8423/cryocooler-board/V4_BOM.csv

Id | Designator | Footprint | Quantity | Designation | Supplier and ref
1 | C11,CIN3 | EEH-ZA1V680XP | 2 | 68uF
2 | C10 | GCM21BR72A104KA37L | 1 | .1uF
3 | J1,J3,J2 | MOLEX_4_pin | 3 | MOL Pico 4
4 | R2,R1 | CRCW12062K20JNEA | 2 | 2.20k
5 | C1,C2,C9 | GCM21BR72A104KA37L | 3 | 0.1uF
6 | C8,C7,CIN4 | CGA3E3X5R1H105M080AB | 3 | 1uF
7 | R5 | CRCW08052K00FKEA | 1 | 5k
8 | U3 | 0685T4000-01 | 1 | C1T 4
9 | Cdith1 | CGA3E2X7R1H473K080AD | 1 | 0.047uF
10 | C3,CIN2,C4,C5,CIN1,C6 | CGA5L1X7R1H106K160AC | 6 | 10uF
11 | TP_VIN1,TP_SCL1,TP_SDA1,TP_VOUT1,TP_AGND1,TP_PGND1 | TestPoint_THTPad_D1.5mm_Drill0.7mm | 6 | TestPoint
12 | U2 | AD5258BRMZ1_IC | 1 | AD5258BRMZ1
13 | R3 | CRF1206-FZ-R010ELF | 1 | 10mili Ohms
14 | R4 | CRCW080530K9FKEA | 1 | 30k
15 | Cp1 | CGA3E2NP01H220J080AA | 1 | 22pF
16 | R8,R7 | CRCW08051R00JNEAHP | 2 | 1 ohm
17 | Rfsw1 | CRCW060310K0FKEA | 1 | 32.4K
18 | Rc1 | CRCW060326K1FKEA | 1 | 26.1k
19 | J4 | MOLEX_2_pin | 1 | MOL Pico 2
20 | R6 | CRCW120620K0FKEAC | 1 | 20k
21 | CVCC1 | GRT188R61C475KE13D | 1 | 4.7uF
22 | Q1,Q2 | IPZ40N04S5L4R8ATMA1 | 2 | IPZ40N04S5-3R1
23 | U1 | TPS55288 | 1 | PTPS55288RPMR
24 | L1 | XAL1010 | 1 | 10uH
25 | Cc1 | CGA3E2C0G1H562J080AA | 1 | 5.6nF
