8423/cryocooler-board/V1_bill_of_materials.csv

Id | Designator | Footprint | Quantity | Designation | Supplier Link | Received
1 | J1,J3,J2 | MOLEX_4_pin | 3 | MOL Pico 4 | https://www.digikey.com/en/products/detail/molex/5040500491/4357649?s=N4IgTCBcDaIKwAYAsDHIJwEYQF0C%2BQA | y
2 | R2,R1 | CRCW12062K20JNEA | 2 | 2.20k | https://www.digikey.com/en/products/detail/vishay-dale/CRCW12062K20JNEA/1176213 | y
3 | C1,C2,C9 | GCM21BR72A104KA37L | 3 | 0.1uF | https://www.digikey.com/en/products/detail/murata-electronics/GCM21BR72A104KA37L/1641663 | y
4 | C8,C7,CIN4 | CGA3E3X5R1H105M080AB | 3 | 1uF | https://www.digikey.com/en/products/detail/tdk-corporation/CGA3E3X5R1H105M080AB/3949746 | y
5 | R5 | CRCW08052K00FKEA | 1 | 2k | https://www.digikey.com/en/products/detail/vishay-dale/CRCW08052K00FKEA/1175669 | y
6 | U3 | 0685T4000-01 | 1 | C1T 4 |  | y
7 | Cdith1 -> | CGA3E2X7R1H473K080AD | 1 | 0.047uF |  | y
8 | C3,CIN2,C4,C5,CIN1,C6 | CGA5L1X7R1H106K160AC | 6 | 10uF |  | y
9 | VIN,SCL,SDA,VOUT,AGND,PGND | TestPoint_Pad_D1.5mm | 6 | TestPoint |  | n/a
10 | U2 | AD5258BRMZ1_IC | 1 | AD5258BRMZ1 |  | y
11 | R3 | CRF1206-FZ-R010ELF | 1 | 10mili Ohms |  | y
12 | R4 | CRCW080530K9FKEA | 1 | 31k |  | y
13 | Cp1 | CGA3E2NP01H220J080AA | 1 | 22pF |  | y
14 | R8,R7 | CRCW08051R00JNEAHP | 2 | 1 ohm |  | y
15 | Rfsw1 -> | CRCW060310K0FKEA | 1 | 10k |  | y
16 | Rc1 | CRCW060326K1FKEA | 1 | 26.1k |  | y
17 | J4 | MOLEX_2_pin | 1 | MOL Pico 2 |  | y
18 | R6 | CRCW120620K0FKEAC | 1 | 20k |  | y
19 | CVCC-> | GRT188R61C475KE13D | 1 | 4.7uF |  | y
20 | Q1,Q2 | IPZ40N04S5L4R8ATMA1 | 2 | IPZ40N04S5-3R1 |  | y
21 | U1 | TPS55288 | 1 | PTPS55288RPMR |  | y
22 | CIN3 | EEH-ZA1V680XP | 1 | 68uF |  | y
23 | L1 | XAL8080-103MED | 1 | 10uH
24 | Cc1 | CGA3E2C0G1H562J080AA | 1 | 5.6nF |  | y
