8423/cryocooler-board/production/Cryocooler_Board_V4.1_bom.csv

Designator | Footprint | Quantity | Value | LCSC Part #
C1, C10, C2, C9 | 0805 | 4 | 0.1uF | C85866
C11, CIN3 | EEH-ZA1V680XP | 2 | 68uF | C242137
C12 | 0603 | 1 | 0.1uF | C189228
C3, C4, C5, C6, CIN1, CIN2 | 1206 | 6 | 10uF | C13585
C7, C8, CIN4 | 0603 | 3 | 1uF | C49326360
CC1 | 0603 | 1 | 5.6nF | C440183
CDITH1 | 0603 | 1 | 15nF | C2180652
CP1 | 0603 | 1 | 100pF | C71664
CVCC1 | 0603 | 1 | 4.7uF | C437574
J1, J3 | MOLEX_4_pin | 2 | MOL Pico 4 | C177235
J2, J4 | MOLEX_2_pin | 2 | MOL Pico 2 | C17575002
L1 | XAL1010 | 1 | 10uH | C6358489
Q1, Q2 | IPZ40N04S5L4R8ATMA1 | 2 | IPZ40N04S5L4R8ATMA1 | C6969335
R3 | 1206 | 1 | 10mOhm | C5629523
R4 | 0805 | 1 | 30k | C844838
R5 | 0805 | 1 | 5.1k | C844854
R6 | 1206 | 1 | 41.2K | C3017228
R7, R8 | 0805 | 2 | 1 ohm | C2078379
RC1 | 0603 | 1 | 26.1k | C844150
RFSW1 | 0603 | 1 | 32.4K | C844154
U1 | TPS55288 | 1 | TPS55288RPMR | C2864583
U2 | AD5258BRMZ1_IC | 1 | AD5258BRMZ1 | C649444
U3 | 0685T4000-01 | 1 | 4A Fuse | C2838918
