8423/cryocooler-board/production/Cryocooler_Board_V3_bom-JLCPCB Assembly Order.xls

JLCPCB BOM Tool - BOM Matching
BOM name：Cryocooler_Board_V3_bom-JLCPCB Assembly Order.xlsx |  |  | Download Time：2026-01-30 10:06:44 |  |  |  | * Our matching results are updated in real-time, but stock and prices may change. If it's been over 24 hours, please re-match before placing your order.
PCB Assembled Qty：5 |  |  | Est. Total Price：87.0094
Your BOM |  |  |  |  | Matched Parts |  |  |  |  |  |  | Order Information
Top Designator | Bottom Designator | Comment | Footprint | JLCPCB Part # | Matches | Part # | Manufacturer | Footprint | Description | Category | Warning | JLCPCB Part # | Product link | Lib Type | Qty | Source | Total Price ($)
C1,C2,C9 |  | 0.1uF | GCM21BR72A104KA37L |  | Select by Customer | GCM21BR72A104KA37L | Murata Electronics | 0805 | 100V 100nF X7R ±10% 0805 Multilayer Ceramic Capacitors MLCC - SMD/SMT ROHS | Multilayer Ceramic Capacitors MLCC - SMD/SMT | 1.The comment (GCM21BR72A104KA37L) of this part does not match the one (0.1uF) provided in your BOM. Please confirm; | C85866 | https://jlcpcb.com/partdetail/MurataElectronics-GCM21BR72A104KA37L/C85866 | Extended | 23 | 23 JLCPCB | 0.4117
C3,C4,C5,C6,CIN1,CIN2 |  | 10uF | CGA5L1X7R1H106K160AC |  | Select by Customer | CL31A106KBHNNNE | Samsung Electro-Mechanics | 1206 | 10uF 50V X5R ±10% 1206 Multilayer Ceramic Capacitors MLCC - SMD/SMT ROHS | Multilayer Ceramic Capacitors MLCC - SMD/SMT | 1.There may be multiple types of parts, but one type of part has been matched. Please check.; | C13585 | https://jlcpcb.com/partdetail/14236-CL31A106KBHNNNE/C13585 | Basic | 30 | 30 JLCPCB | 1.776
C7,C8,CIN4 |  | 1uF | CGA3E3X5R1H105M080AB |  | Select by Customer | 0603X5R105K500NT | AIDE CAPACITOR | 0603 | 1uF 50V X5R ±10% 0603 Multilayer Ceramic Capacitors MLCC - SMD/SMT ROHS |  | 1.There may be multiple types of parts, but one type of part has been matched. Please check.; | C49326360 | https://jlcpcb.com/partdetail/AIDECAPACITOR-0603X5R105K500NT/C49326360 | Extended | 21 | 21 JLCPCB | 0.1533
CC1 |  | 5.6nF | CGA3E2C0G1H562J080AA |  | Select by Customer | 0603B562K500NT | FH (Guangdong Fenghua Advanced Tech) | 0603 | 5.6nF 50V X7R ±10% 0603 Multilayer Ceramic Capacitors MLCC - SMD/SMT ROHS | Multilayer Ceramic Capacitors MLCC - SMD/SMT |  | C1628 | https://jlcpcb.com/partdetail/1980-0603B562K500NT/C1628 | Extended | 20 | 20 JLCPCB | 0.06
CDITH1 |  | 0.047uF | CGA3E2X7R1H473K080AD |  | Select by Customer | CGA3E2X7R1H473KT0Y0N | TDK | 0603 | 47nF 50V X7R ±10% 0603 Multilayer Ceramic Capacitors MLCC - SMD/SMT ROHS | Multilayer Ceramic Capacitors MLCC - SMD/SMT | 1.The comment (CGA3E2X7R1H473KT0Y0N) of this part does not match the one (0.047uF) provided in your BOM. Please confirm; | C76712 | https://jlcpcb.com/partdetail/TDK-CGA3E2X7R1H473KT0Y0N/C76712 | Extended | 20 | 20 JLCPCB | 0.152
CIN3 |  | 68uF | EEH-ZA1V680XP |  | Select by Customer | EEHZA1V680XP | PANASONIC | SMD,D6.3xL7.7mm | -55℃~+105℃ 10000hrs@105℃ 300mA@100Hz 35V 35mΩ 6.3mm 68uF 7.7mm ±20% SMD,D6.3xL7.7mm Hybrid Aluminum Electrolytic Capacitors ROHS | Hybrid Aluminum Electrolytic Capacitors |  | C242137 | https://jlcpcb.com/partdetail/PANASONIC-EEHZA1V680XP/C242137 | Extended | 5 | 5 JLCPCB | 2.1115
CP1 |  | 22pF | CGA3E2NP01H220J080AA |  | Select by Customer | 0603C0G220K500NT | AIDE CAPACITOR | 0603 | 22pF 50V C0G ±10% 0603 Multilayer Ceramic Capacitors MLCC - SMD/SMT ROHS |  |  | C49326310 | https://jlcpcb.com/partdetail/AIDECAPACITOR-0603C0G220K500NT/C49326310 | Extended | 20 | 20 JLCPCB | 0.064
CVCC1 |  | 4.7uF | GRT188R61C475KE13D |  | Select by Customer | GRT188R61C475KE13D | Murata Electronics | 0603 | 16V 4.7uF X5R ±10% 0603 Multilayer Ceramic Capacitors MLCC - SMD/SMT ROHS | Multilayer Ceramic Capacitors MLCC - SMD/SMT |  | C437574 | https://jlcpcb.com/partdetail/436029-GRT188R61C475KE13D/C437574 | Extended | 9 | 9 JLCPCB | 0.6966
J1,J2,J3 |  | MOLPico4 | MOLEX_4_pin |  | Select by Customer | 5040500491 | MOLEX | SMD,P=1.5mm,卧贴 | -40℃~+105℃ 1 1.5mm 150V 1x4P 3A 4 4P Black Copper alloy Gold Surface Mount, Right Angle UL94V-0 SMD,P=1.5mm,Surface Mount，Right Angle Wire To Board Connector ROHS | Wire To Board Connector |  | C177235 | https://jlcpcb.com/partdetail/MOLEX-5040500491/C177235 | Extended | 15 | 15 JLCPCB | 5.232
J4 |  | MOLPico2 | MOLEX_2_pin |  | Select by Customer | 2053380002 | MOLEX | SMD | -40℃~+105℃ 1 1x2P 2 250V 2P 2mm 6.5A Black Copper alloy Gold Surface Mount, Right Angle UL94V-0 SMD Wire To Board Connector ROHS | Wire To Board Connector |  | C17575002 | https://jlcpcb.com/partdetail/MOLEX-2053380002/C17575002 | Extended | 5 | 5 JLCPCB | 13.9145
L1 |  | 10uH | XAL1010 |  | Select by Customer | XAL1010-103MED | Coilcraft | - | 10uH 14.75mΩ 15.5A 17.5A AEC-Q200 Magnetic Shielded Inductor ±20% - Power Inductors ROHS | Power Inductors |  | C6358489 | https://jlcpcb.com/partdetail/Coilcraft-XAL1010103MED/C6358489 | Extended | 5 | 5 JLCPCB | 24.7835
Q1,Q2 |  | IPZ40N04S5-3R1 | IPZ40N04S5L4R8ATMA1 |  | Select by Customer | IPZ40N04S5L4R8ATMA1 | Infineon Technologies | TSDSON-8FL | -55℃~+175℃ 1 N-channel 1.56nF 27pF 29nC@10V 2V 4.8mΩ@10V 40A 40V 48W TSDSON-8FL MOSFETs ROHS | MOSFETs | 1.The comment (IPZ40N04S5L4R8ATMA1) of this part does not match the one (IPZ40N04S5-3R1) provided in your BOM. Please confirm; | C6969335 | https://jlcpcb.com/partdetail/7935262-IPZ40N04S5L4R8ATMA1/C6969335 | Extended | 10 | 10 JLCPCB | 3.626
R1,R2 |  | CRCW12062K20JNEA | CRCW12062K20JNEA |  | Select by Customer | CRCW12062K20JNEA | Vishay Intertech | 1206 | -55℃~+155℃ 2.2kΩ 250mW Thick Film Resistor ±200ppm/℃ ±5% 1206 Chip Resistor - Surface Mount ROHS | Chip Resistor - Surface Mount |  | C6538126 | https://jlcpcb.com/partdetail/VishayIntertech-CRCW12062K20JNEA/C6538126 | Extended | 15 | 15 JLCPCB | 0.279
R3 |  | 10miliOhms | CRF1206-FZ-R010ELF |  | Select by Customer | CRF1206-FZ-R010ELF | BOURNS | 1206 | -55℃~+170℃ 10mΩ 1W ±1% ±50ppm/℃ 1206 Chip Resistor - Surface Mount ROHS | Chip Resistor - Surface Mount |  | C5629523 | https://jlcpcb.com/partdetail/BOURNS-CRF1206_FZR010ELF/C5629523 | Extended | 5 | 5 JLCPCB | 3.618
R4 |  | CRCW080530K9FKEA | CRCW080530K9FKEA |  | Select by System | CRCW080530K9FKEA | Vishay Intertech | 0805 | -55℃~+155℃ 125mW 30.9kΩ Thick Film Resistor ±1% ±100ppm/℃ 0805 Chip Resistor - Surface Mount ROHS | Chip Resistor - Surface Mount |  | C4257940 | https://jlcpcb.com/partdetail/VishayIntertech-CRCW080530K9FKEA/C4257940 | Extended | 20 | 20 JLCPCB | 0.294
R5 |  | CRCW08052K00FKEA | CRCW08052K00FKEA |  | Select by System | CRCW08052K00FKEA | Vishay Intertech | 0805 | -55℃~+155℃ 125mW 150V 2kΩ Thick Film Resistor ±1% ±100ppm/℃ 0805 Chip Resistor - Surface Mount ROHS | Chip Resistor - Surface Mount |  | C844834 | https://jlcpcb.com/partdetail/VishayIntertech-CRCW08052K00FKEA/C844834 | Extended | 20 | 20 JLCPCB | 0.182
R6 |  | CRCW120620K0FKEAC | CRCW120620K0FKEAC |  | Select by System | CRCW120620K0FKEAC | Vishay Intertech | 1206 | -55℃~+155℃ 20kΩ 250mW Thick Film Resistor ±1% ±100ppm/℃ 1206 Chip Resistor - Surface Mount ROHS | Chip Resistor - Surface Mount |  | C844022 | https://jlcpcb.com/partdetail/VishayIntertech-CRCW120620K0FKEAC/C844022 | Extended | 15 | 15 JLCPCB | 0.243
R7,R8 |  | CRCW08051R00JNEAHP | CRCW08051R00JNEAHP |  | Select by Customer | CRCW08051R00JNEAHP | Vishay Intertech | 0805 | -55℃~+155℃ 150V 1Ω 500mW Thick Film Resistor ±200ppm/℃ ±5% 0805 Chip Resistor - Surface Mount ROHS | Chip Resistor - Surface Mount |  | C2078379 | https://jlcpcb.com/partdetail/VishayIntertech-CRCW08051R00JNEAHP/C2078379 | Extended | 12 | 12 JLCPCB | 1.0668
RC1 |  | 26.1k | CRCW060326K1FKEA |  | Select by Customer | CRCW060326K1FKEA | Vishay Intertech | 0603 | -55℃~+155℃ 100mW 26.1kΩ Thick Film Resistor ±1% ±100ppm/℃ 0603 Chip Resistor - Surface Mount ROHS | Chip Resistor - Surface Mount | 1.The comment (CRCW060326K1FKEA) of this part does not match the one (26.1k) provided in your BOM. Please confirm; | C844150 | https://jlcpcb.com/partdetail/VishayIntertech-CRCW060326K1FKEA/C844150 | Extended | 20 | 20 JLCPCB | 0.086
RFSW1 |  | 10k | CRCW060310K0FKEA |  | Select by Customer | CRCW060310K0FKEA | Vishay Intertech | 0603 | -55℃~+155℃ 100mW 10kΩ 75V Thick Film Resistor ±1% ±100ppm/℃ 0603 Chip Resistor - Surface Mount ROHS | Chip Resistor - Surface Mount |  | C844918 | https://jlcpcb.com/partdetail/VishayIntertech-CRCW060310K0FKEA/C844918 | Extended | 20 | 20 JLCPCB | 0.084
U1 |  | PTPS55288RPMR | TPS55288 |  | Select by Customer | TPS55288RPMR | Texas Instruments | VQFN-26-HR(3.5x4) | -40℃~+125℃@(TJ) 1 16A 2.2MHz 2.7V~36V 800mV~22V 860uA Adjustable Buck-Boost Buck-Boost Built-in Yes VQFN-26-HR(3.5x4) DC-DC Converters ROHS | DC-DC Converters |  | C2864583 | https://jlcpcb.com/partdetail/TexasInstruments-TPS55288RPMR/C2864583 | Extended | 5 | 5 JLCPCB | 16.9595
U2 |  | AD5258BRMZ1 | AD5258BRMZ1_IC |  | Select by Customer | AD5258BRMZ1 | Analog Devices | MSOP-10 | -40℃~+85℃ 1 1kΩ 2.7V~5.5V 200ppm/℃ 500nA 64 EEPROM I2C Linear ±30% MSOP-10 Digital Potentiometers ROHS | Digital Potentiometers |  | C649444 | https://jlcpcb.com/partdetail/AnalogDevices-AD5258BRMZ1/C649444 | Extended | 5 | 5 JLCPCB | 10.532
U3 |  | C1T4 | 0685T4000-01 |  | Select by Customer | 1206TD-4A | prosemi | 1206 | -55℃~+150℃ 1.6mm 3.1 3.2mm 4A 50A@72VDC、150A@32VDC、300A@24VDC 72V Surface Mount Fuse 1206 Disposable fuses ROHS | Disposable Fuses |  | C2838918 | https://jlcpcb.com/partdetail/prosemi-1206TD4A/C2838918 | Extended | 9 | 9 JLCPCB | 0.684
