8423/cryocooler-board/Footprints+Symbols/3d_symbols/EEH-ZA1V680XP.step

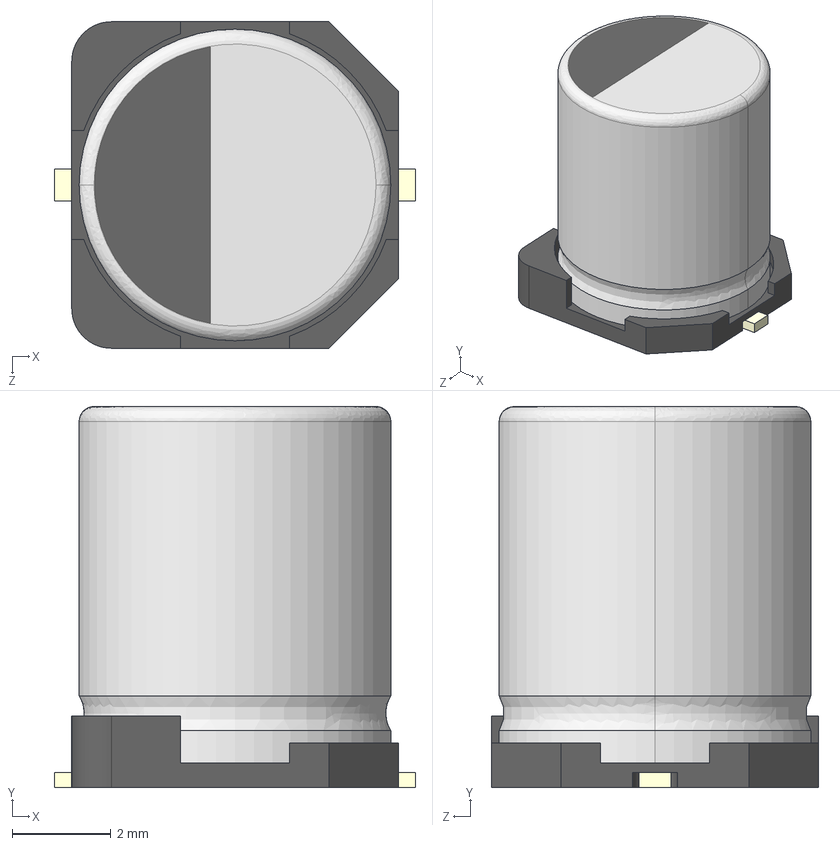
[picture p21: CAD file, 2026-10-12]
Footprints+Symbols/3d_symbols/EEH-ZA1V680XP.step
7.30 x 7.70 x 6.60 mm
