8423/cryocooler-board/Footprints+Symbols/3d_symbols/CRCW04022K20FKED.step

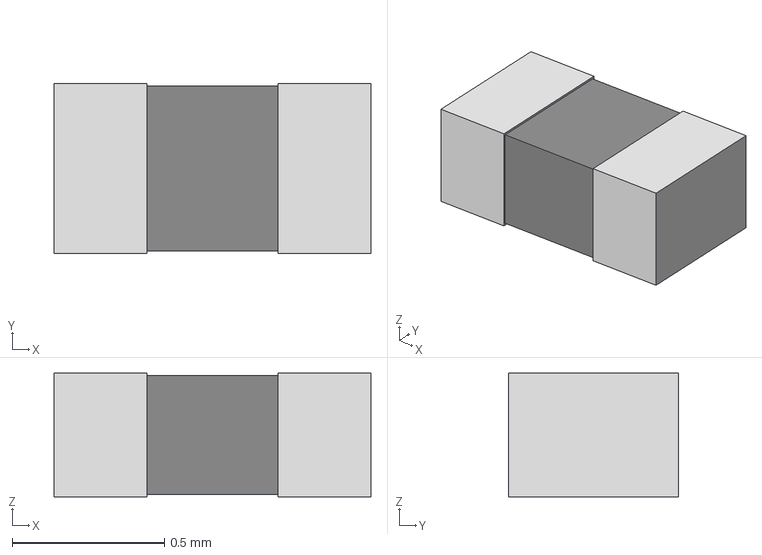
[picture p22: CAD file, 2026-10-12]
Footprints+Symbols/3d_symbols/CRCW04022K20FKED.step
1.04 x 0.558 x 0.406 mm
