8423/cryocooler-board/Footprints+Symbols/3d_symbols/IPZ40N04S5L4R8ATMA1.step

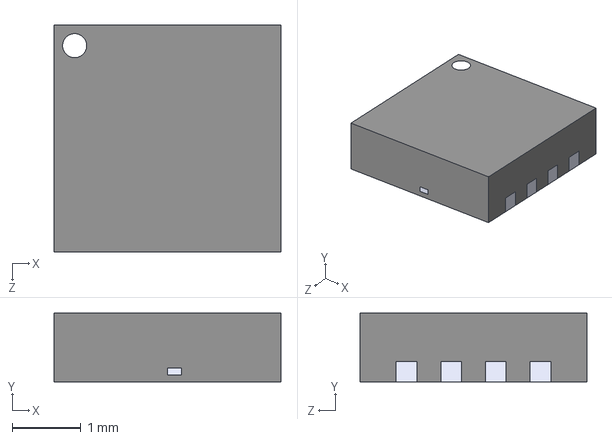
[picture p23: CAD file, 2026-10-12]
Footprints+Symbols/3d_symbols/IPZ40N04S5L4R8ATMA1.step
3.30 x 1.00 x 3.30 mm
