8423/cryocooler-board/Footprints+Symbols/3d_symbols/GCM188L81H104KA57D.stp

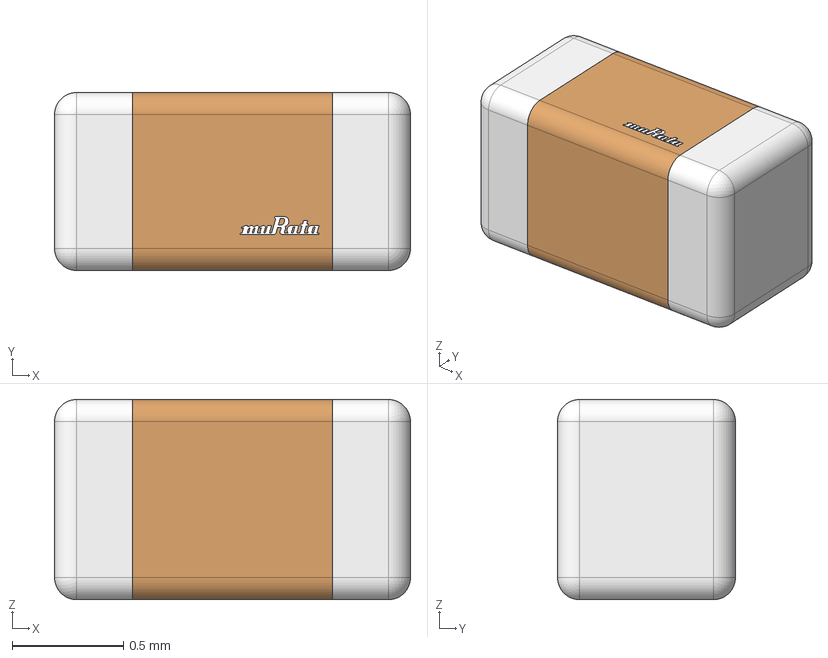
[picture p24: CAD file, 2026-10-12]
Footprints+Symbols/3d_symbols/GCM188L81H104KA57D.stp
1.60 x 0.8 x 0.901 mm
