8423/cryocooler-board/Footprints+Symbols/3d_symbols/XAL1010-472MED.step

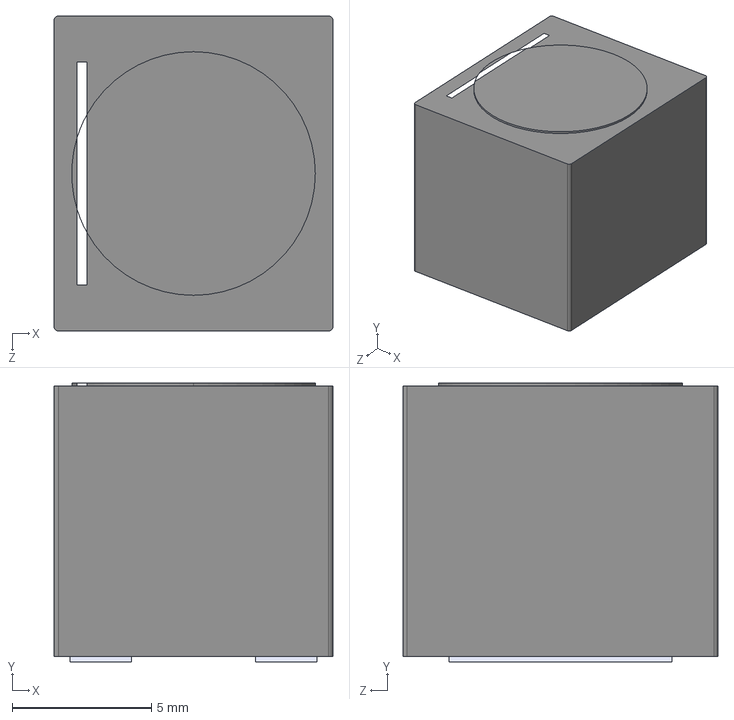
[picture p25: CAD file, 2026-10-12]
Footprints+Symbols/3d_symbols/XAL1010-472MED.step
10.0 x 10.0 x 11.3 mm
