8423/cryocooler-board/Footprints+Symbols/3d_symbols/MOLEX_3_pin.stp

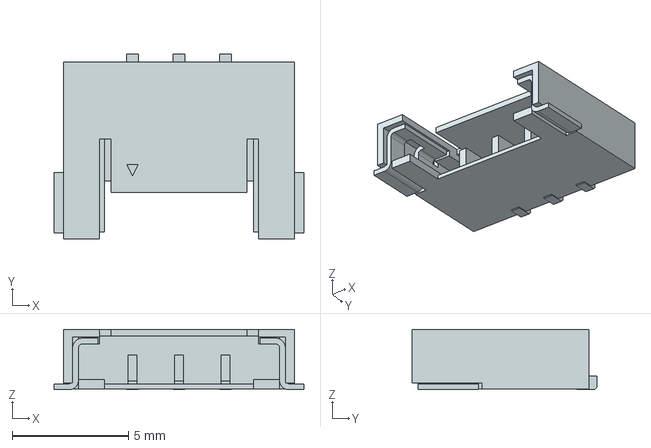
[picture p26: CAD file, 2026-10-12]
Footprints+Symbols/3d_symbols/MOLEX_3_pin.stp
10.7 x 7.95 x 2.60 mm
