8423/cryocooler-board/Footprints+Symbols/3d_symbols/CGA2B2C0G1H220J050BA.stp

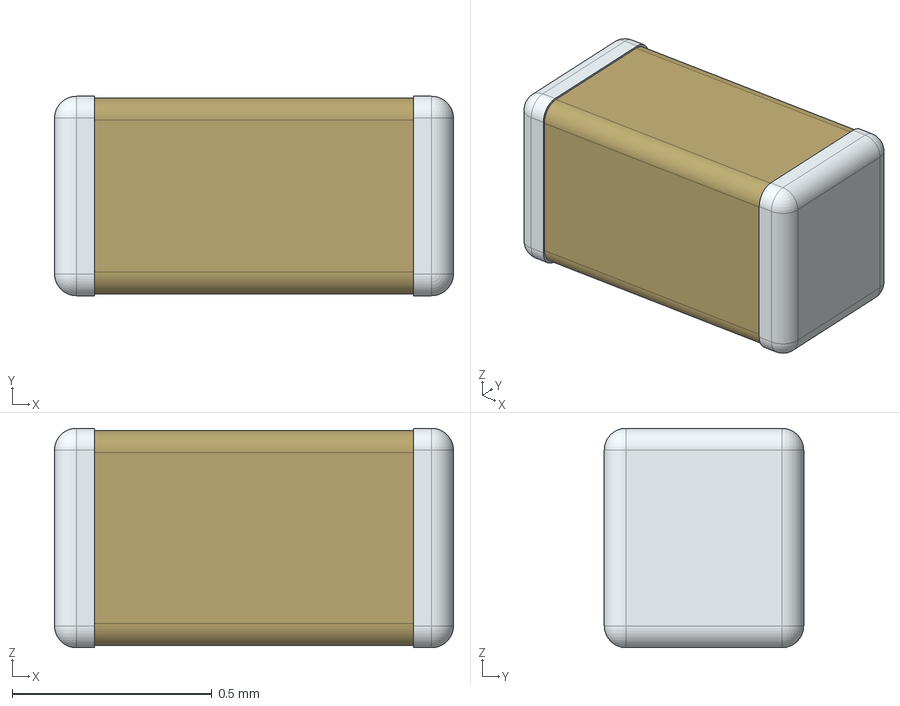
[picture p27: CAD file, 2026-10-12]
Footprints+Symbols/3d_symbols/CGA2B2C0G1H220J050BA.stp
1.00 x 0.5 x 0.55 mm
