8423/cryocooler-board/Footprints+Symbols/3d_symbols/CGA3E3X5R1H105M080AB.step

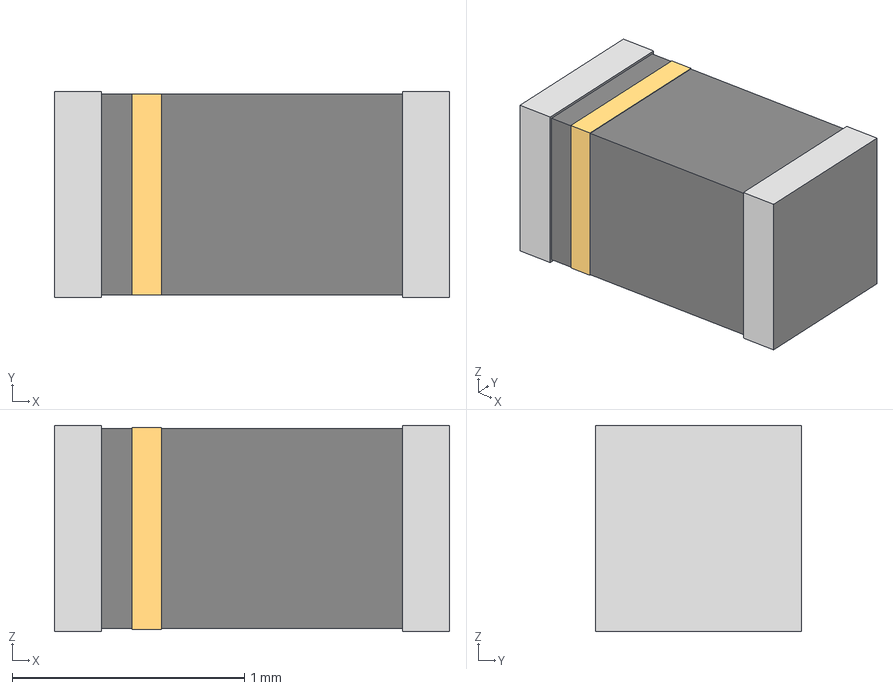
[picture p28: CAD file, 2026-10-12]
Footprints+Symbols/3d_symbols/CGA3E3X5R1H105M080AB.step
1.70 x 0.888 x 0.889 mm
