8423/cryocooler-board/Footprints+Symbols/3d_symbols/GCM21BR72A104KA37L.step

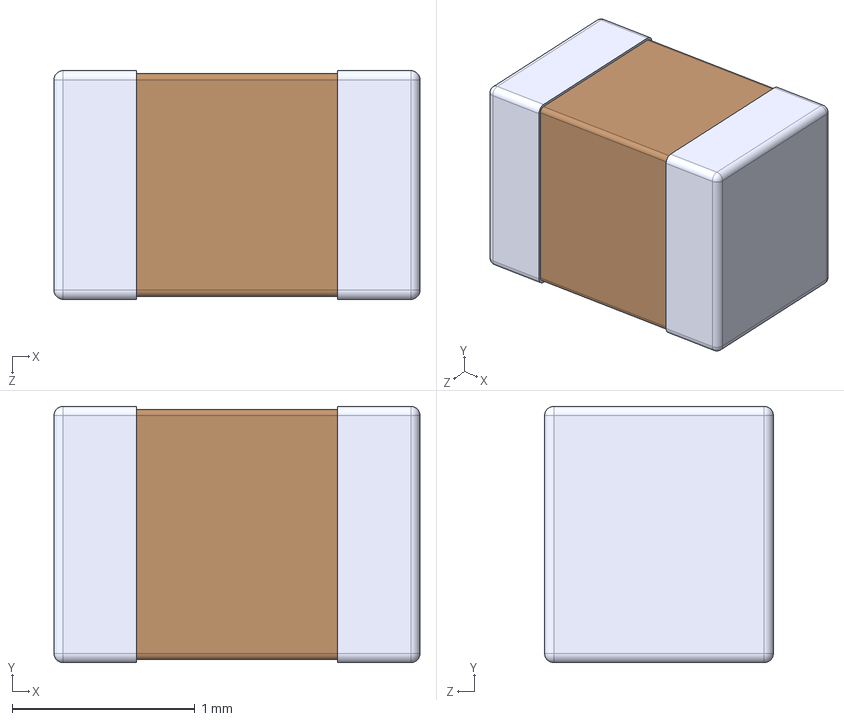
[picture p29: CAD file, 2026-10-12]
Footprints+Symbols/3d_symbols/GCM21BR72A104KA37L.step
2.00 x 1.40 x 1.25 mm
