8423/cryocooler-board/Footprints+Symbols/3d_symbols/MOLEX_8_pin.stp

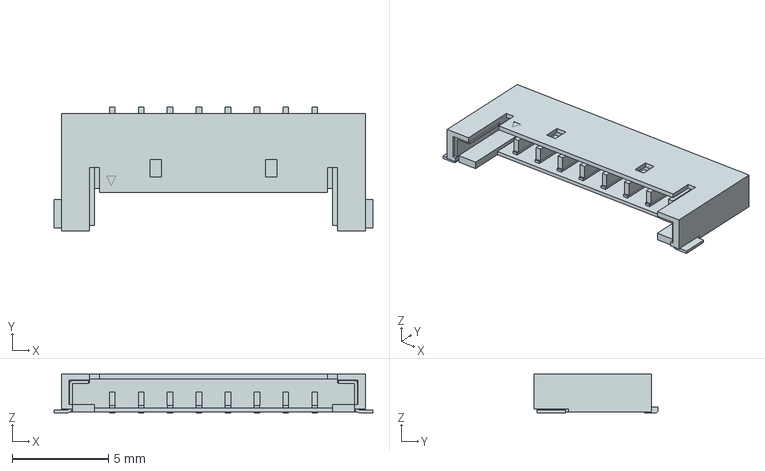
[picture p30: CAD file, 2026-10-12]
Footprints+Symbols/3d_symbols/MOLEX_8_pin.stp
16.6 x 6.44 x 2.00 mm
