8423/cryocooler-board/Footprints+Symbols/3d_symbols/XAL8080-103MED.stp

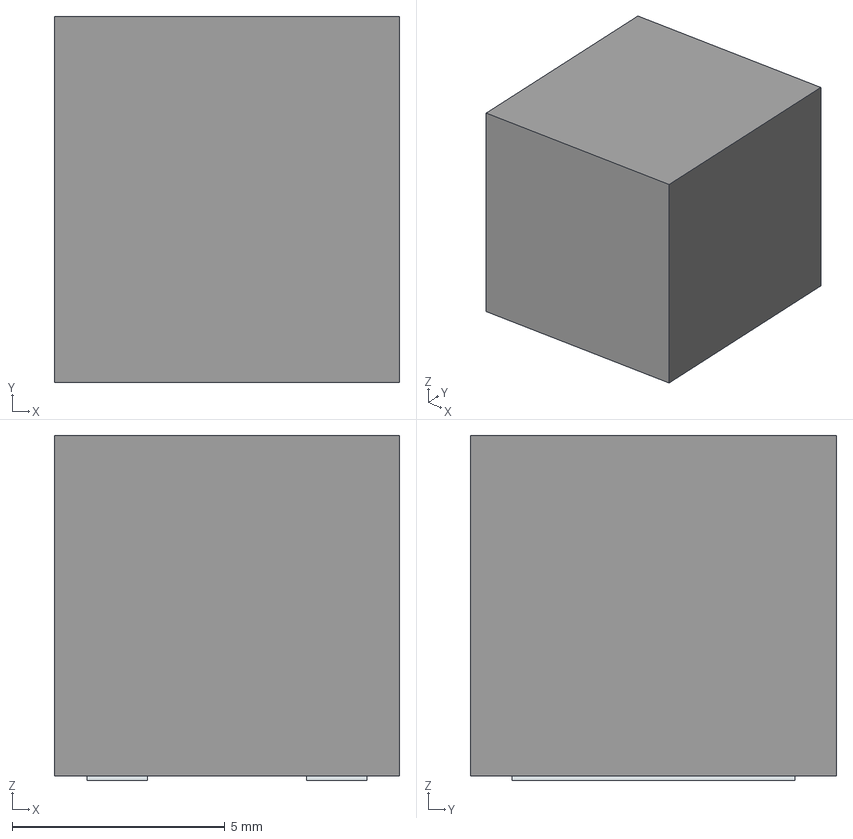
[picture p31: CAD file, 2026-10-12]
Footprints+Symbols/3d_symbols/XAL8080-103MED.stp
8.10 x 8.60 x 8.10 mm
Pins
