8423/cryocooler-board/Footprints+Symbols/3d_symbols/CRCW08051R00JNEAHP.step

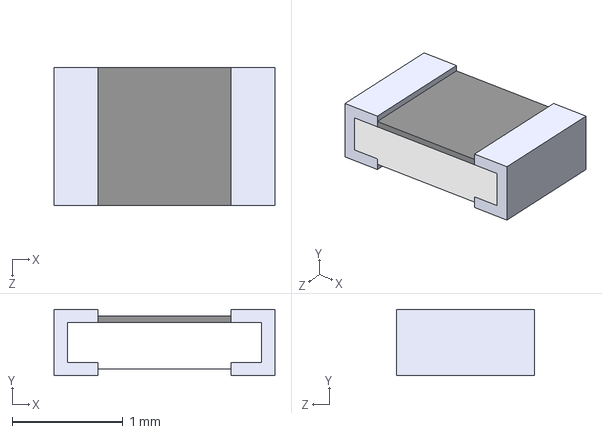
[picture p32: CAD file, 2026-10-12]
Footprints+Symbols/3d_symbols/CRCW08051R00JNEAHP.step
2.00 x 0.6 x 1.25 mm
