8423/cryocooler-board/Footprints+Symbols/3d_symbols/CRCW120620K0FKEAC.step

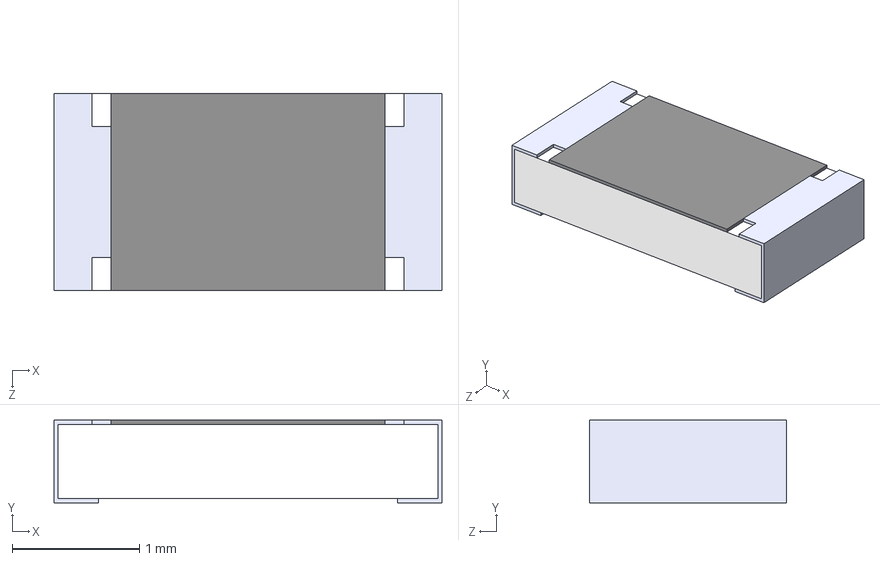
[picture p33: CAD file, 2026-10-12]
Footprints+Symbols/3d_symbols/CRCW120620K0FKEAC.step
3.05 x 0.65 x 1.55 mm
