8423/cryocooler-board/Footprints+Symbols/3d_symbols/CGA1A2C0G1H220J030BA.stp

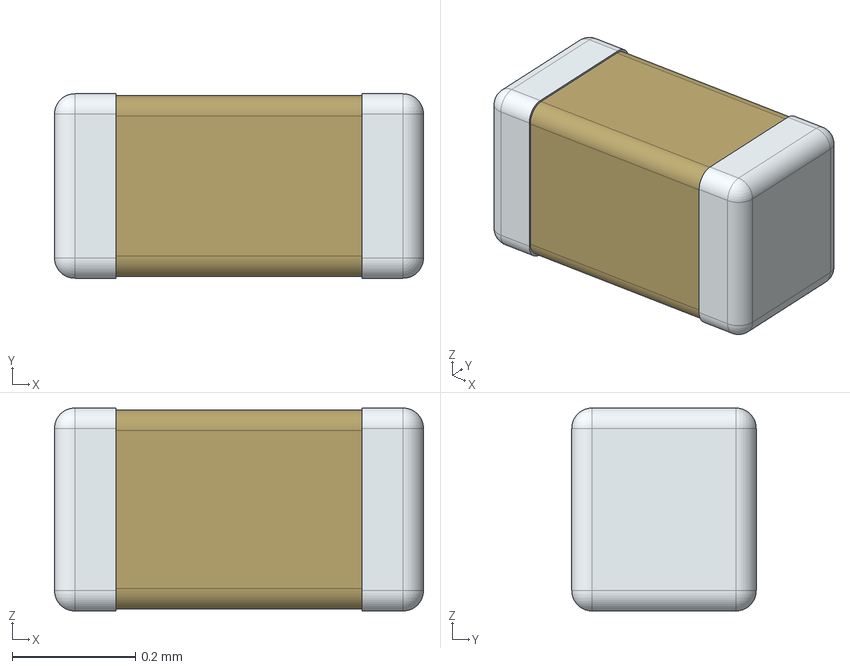
[picture p34: CAD file, 2026-10-12]
Footprints+Symbols/3d_symbols/CGA1A2C0G1H220J030BA.stp
0.6 x 0.3 x 0.33 mm
