8423/cryocooler-board/Footprints+Symbols/3d_symbols/0685T4000-01.step

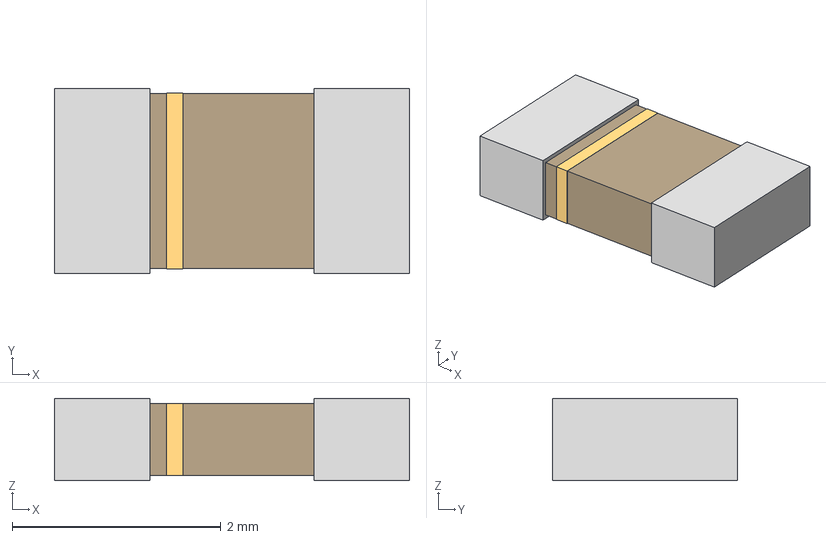
[picture p35: CAD file, 2026-10-12]
Footprints+Symbols/3d_symbols/0685T4000-01.step
3.40 x 1.78 x 0.787 mm
