8423/cryocooler-board/(list of files, cad)

Other CAD files:
Footprints+Symbols/3d_symbols/CGA3E2NP01H220J080AA.step
Footprints+Symbols/3d_symbols/CGA2B3X7R1H473K050BB.stp
