8423/cryocooler-board/cryocooler-board.kicad_pcb

## KiCad design cryocooler-board.kicad_pcb (2026-10-14)

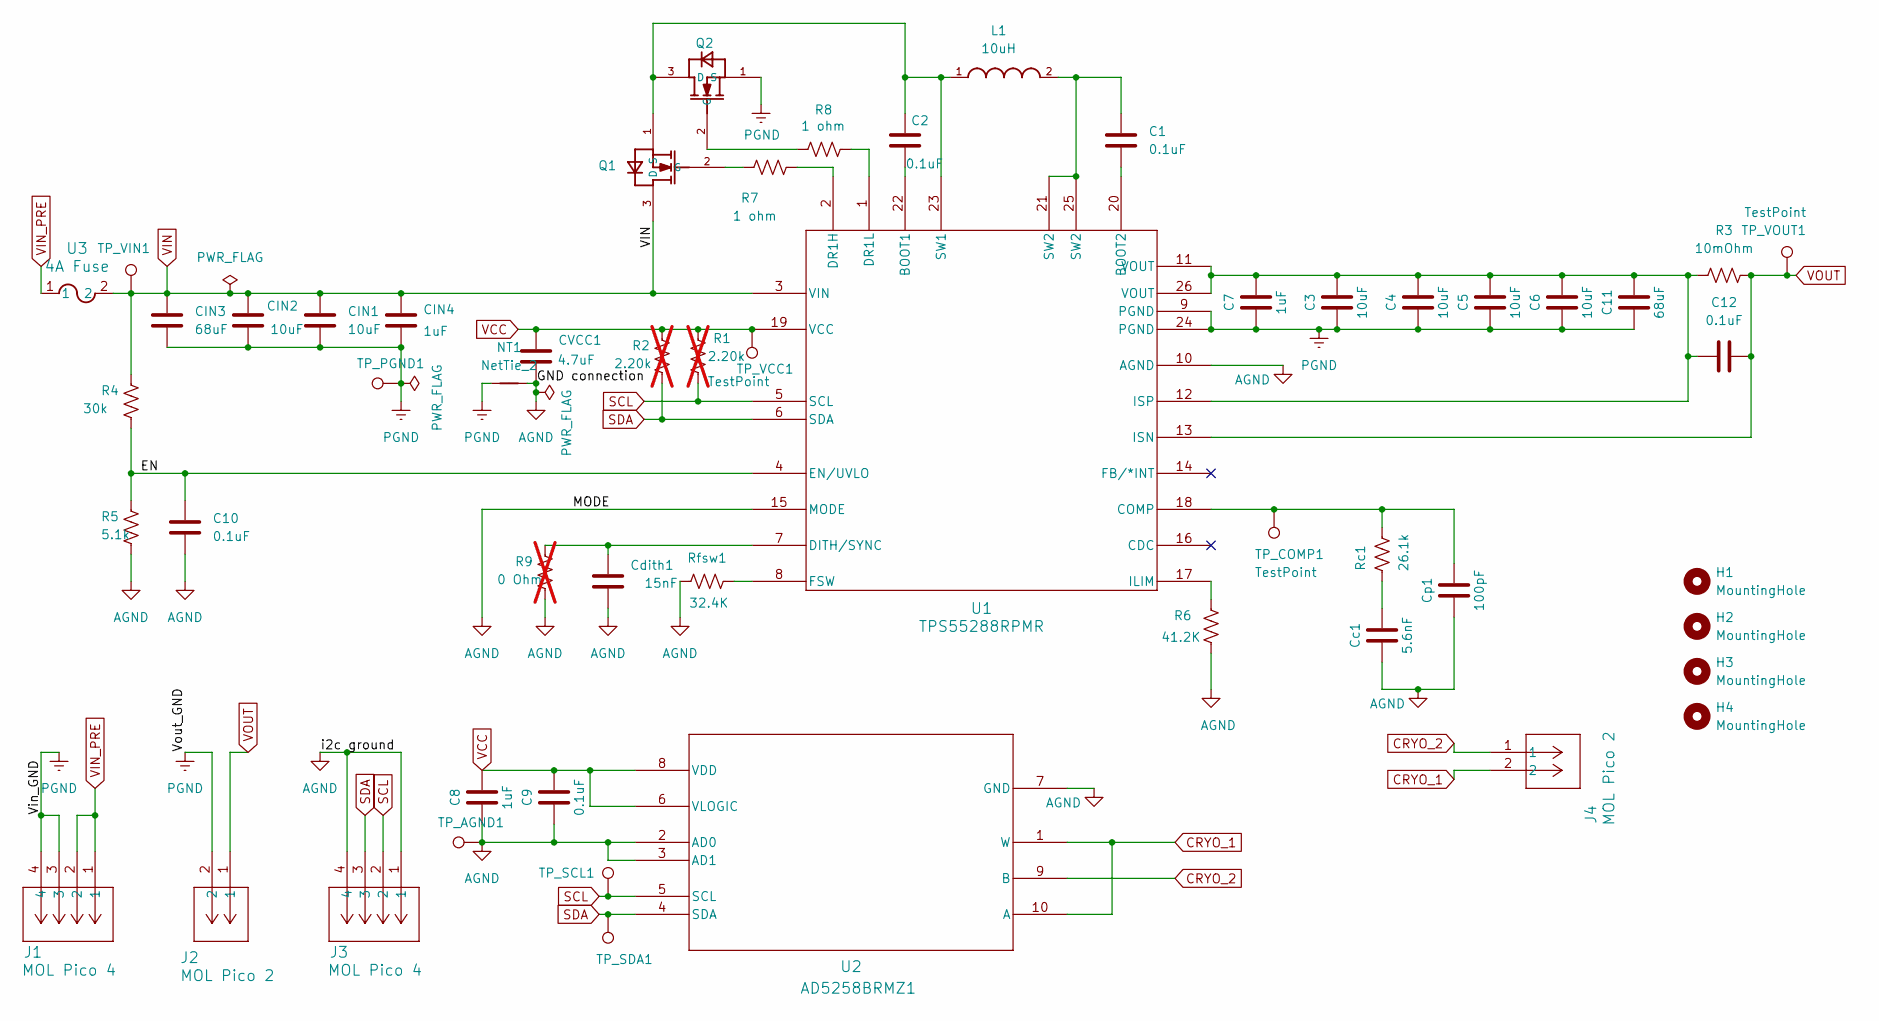
[picture p36: schematic cryocooler-board.kicad_sch, Cryocooler Board]

Parts:
C1, C2, C9, C10: 0.1uF; C_0805_2012Metric; LCSC Part # C85866
C3, C4, C5, C6: 10uF; C_1206_3216Metric; LCSC Part # C13585
C7, C8: 1uF; C_0603_1608Metric; LCSC Part # C49326360
C11: 68uF; EEH-ZA1V680XP; LCSC Part # C242137
C12: 0.1uF; C_0603_1608Metric; LCSC Part # C189228
CIN1, CIN2: 10uF; C_1206_3216Metric; LCSC Part # C13585
CIN3: 68uF; EEH-ZA1V680XP; LCSC Part # C242137
CIN4: 1uF; C_0603_1608Metric; LCSC Part # C49326360
CVCC1: 4.7uF; C_0603_1608Metric; LCSC Part # C437574
Cc1: 5.6nF; C_0603_1608Metric; LCSC Part # C440183
Cdith1: 15nF; C_0603_1608Metric; LCSC Part # C2180652
Cp1: 100pF; C_0603_1608Metric; LCSC Part # C71664
H1, H2, H3, H4: MountingHole; M3_3_4mm_hole
J1, J3: MOL Pico 4; MOLEX_4_pin; LCSC Part # C177235
J2, J4: MOL Pico 2; MOLEX_2_pin; LCSC Part # C17575002
L1: 10uH; XAL1010; LCSC Part # C6358489
NT1: NetTie_2; NetTie-2_SMD_Pad0.3mm
Q1, Q2: IPZ40N04S5L4R8ATMA1; LCSC Part # C6969335
R1, R2: 2.20k; R_1206_3216Metric; LCSC Part # C6538126; not fitted
R3: 10mOhm; R_1206_3216Metric; LCSC Part # C5629523
R4: 30k; R_0805_2012Metric; LCSC Part # C844838
R5: 5.1k; R_0805_2012Metric; LCSC Part # C844854
R6: 41.2K; R_1206_3216Metric; LCSC Part # C3017228
R7, R8: 1 ohm; R_0805_2012Metric; LCSC Part # C2078379
R9: 0 Ohm; R_0603_1608Metric; LCSC Part # C21189; not fitted
Rc1: 26.1k; R_0603_1608Metric; LCSC Part # C844150
Rfsw1: 32.4K; R_0603_1608Metric; LCSC Part # C844154
TP_AGND1: TestPoint; TestPoint_THTPad_D1.5mm_Drill0.7mm
TP_COMP1: TestPoint; TestPoint_THTPad_D1.5mm_Drill0.7mm
TP_PGND1: TestPoint; TestPoint_THTPad_D1.5mm_Drill0.7mm
TP_SCL1: TestPoint; TestPoint_THTPad_D1.5mm_Drill0.7mm
TP_SDA1: TestPoint; TestPoint_THTPad_D1.5mm_Drill0.7mm
TP_VCC1: TestPoint; TestPoint_THTPad_D1.5mm_Drill0.7mm
TP_VIN1: TestPoint; TestPoint_THTPad_D1.5mm_Drill0.7mm
TP_VOUT1: TestPoint; TestPoint_THTPad_D1.5mm_Drill0.7mm
U1: TPS55288RPMR; TPS55288; LCSC Part # C2864583
U2: AD5258BRMZ1; AD5258BRMZ1_IC; LCSC Part # C649444
U3: 4A Fuse; 0685T4000-01; LCSC Part # C2838918

Connections:
/EN: C10.1, R4.2, R5.1, U1.4 (EN/UVLO)
AGND: C8.2, C9.2, C10.2, CVCC1.1, Cc1.2, Cdith1.1, Cp1.2, J3.1, J3.4, NT1.2, R5.2, R6.2, R9.2, Rfsw1.1, TP_AGND1.1, U1.10 (AGND), U1.15 (MODE), U2.2 (AD0), U2.3 (AD1), U2.7 (GND)
CRYO_1: J4.2, U2.1 (W), U2.10 (A)
CRYO_2: J4.1, U2.9 (B)
unnamed: C1.1, L1.2, U1.21 (SW2), U1.25 (SW2)
unnamed: Cc1.1, Rc1.1
unnamed: Q1.2 (G), R7.1
unnamed: C2.1, L1.1, Q1.1 (S), Q2.3 (D), U1.23 (SW1)
unnamed: Q2.2 (G), R8.1
unnamed: C2.2, U1.22 (BOOT1)
unnamed: C1.2, U1.20 (BOOT2)
unnamed: Cp1.1, Rc1.2, TP_COMP1.1, U1.18 (COMP)
unnamed: Cdith1.2, R9.1, U1.7 (DITH/SYNC)
unnamed: R7.2, U1.2 (DR1H)
unnamed: R8.2, U1.1 (DR1L)
unnamed: Rfsw1.2, U1.8 (FSW)
unnamed: R6.1, U1.17 (ILIM)
unnamed: C3.1, C4.1, C5.1, C6.1, C7.1, C11.1, C12.1, R3.1, U1.11 (VOUT), U1.12 (ISP), U1.26 (VOUT)
SCL: J3.2, R1.2, TP_SCL1.1, U1.5 (SCL), U2.5 (SCL)
SDA: J3.3, R2.2, TP_SDA1.1, U1.6 (SDA), U2.4 (SDA)
VCC: C8.1, C9.1, CVCC1.2, R1.1, R2.1, TP_VCC1.1, U1.19 (VCC), U2.6 (VLOGIC), U2.8 (VDD)
VIN_PRE: J1.1, J1.2, U3.1
VOUT: C12.2, J2.1, R3.2, TP_VOUT1.1, U1.13 (ISN)

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
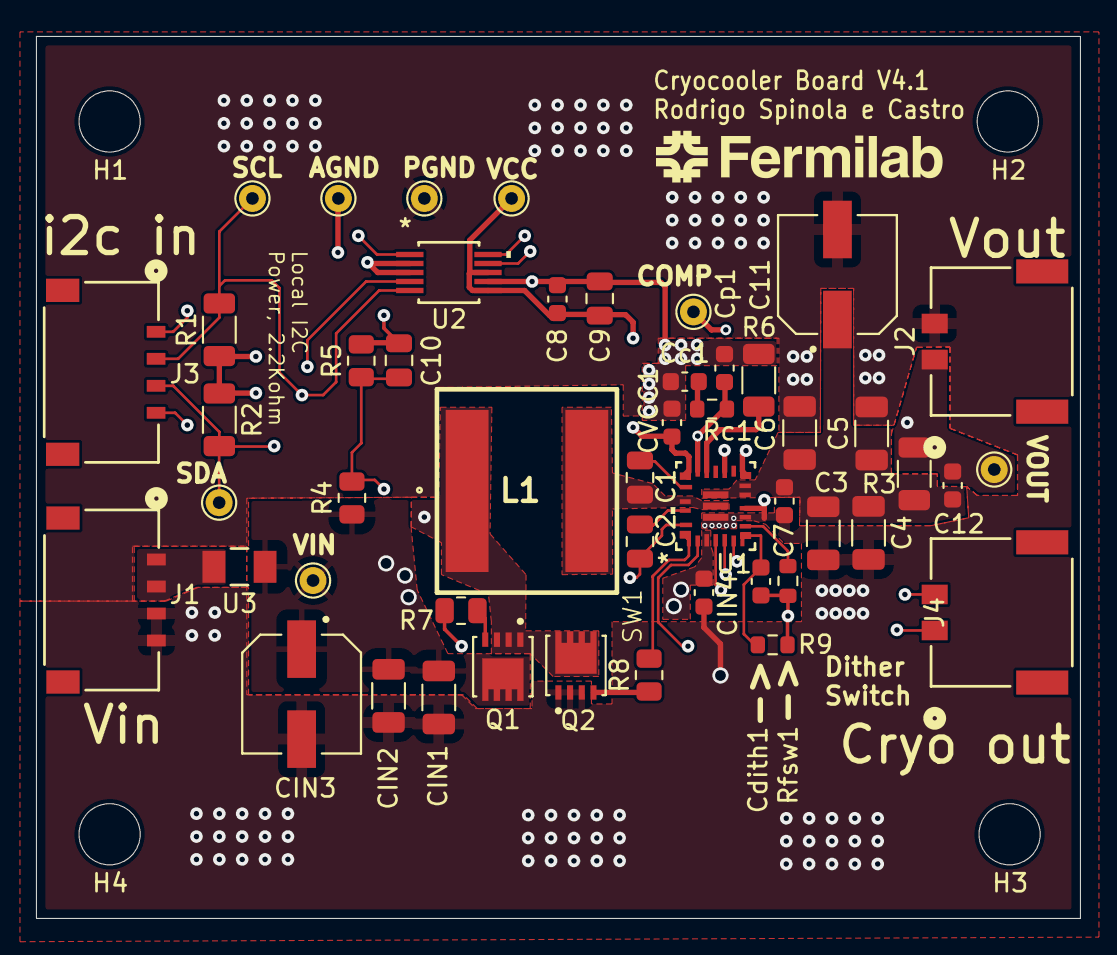
[picture p37: board cryocooler-board.kicad_pcb from above]

Board: 4 copper layers, 58.0 x 49.0 mm, 54 parts (0 on the bottom side), 25 nets.
