8423/cryocooler-board/(commit log)

2026-10-12 V4: TPS55288 cryocooler board, 2-pin Pico-Lock on J4
2026-10-12 V4.1 (work in progress): J4 changed to 4-pin Pico-Lock 5040500491
2026-10-12 Tidy: rename project to cryocooler-board, move docs and scripts, drop stale V4 outputs
2026-10-12 Reorganize libraries: lib/Cryocooler symbols, footprints and 3D models; custom NT1 net tie; L1 symbol corrected to XAL1010-103MED; add 2-pin Molex for future use
2026-10-12 Add README with design overview, V3 lessons, connectors and layer images
2026-10-13 V4.1:Cryocooler VOUT connector changed to 2-pin Pico-Lock 2053380002 (J5); R3 and TP_VOUT1 moved
2026-10-13 README: V4.1 connectors, 3D view and updated layer screenshots
2026-10-13 V4.1: J4 (cryocooler set point) back to 2-pin Pico-Lock 2053380002; CRYO_1/CRYO_2 rerouted
2026-10-13 README: J4 back to 2-pin; refreshed layer screenshots and 3D view
2026-10-13 V4.1: R1/R2 (I2C pull-ups) DNP for 3.3 V host; exclude DNP parts from JLC output; J4 value fixed
    README: I2C level issue added to open items (provisional decision)
2026-10-14 V4.1 as ordered: loop-stability test build
    - Values: Cp1 100 pF C0G, Cc1 C0G, R6 41.2k (8 A), R5 5.1k, Cdith1 15 nF
    - Added C12 (ISP-ISN filter), R9 (DNP dither disable), TP_COMP1, TP_VCC1
    - R7 moved next to Q1 gate; passives on standard IPC footprints
    - MF/MP/LCSC fields on all parts; ERC fixes (PWR_FLAGs, pin types)
    - Production files regenerated (Fabrication Toolkit)
    - README updated; new 3D, layer and Bode images (12 V and 20 V)
